oretizy03/Soil-Monitoring-System/Soil_Monitoring_for_Smart_Agriculture.pptx

SOIL
MONITORING
FOR SMART
AGRICULTURE

Sensor-based soil monitoring with real-time measurements, local classification and an offline dashboard

EEG 323 — Instrumentation and Measurement II | Group 2

Department of Electrical and Electronics Engineering · University of Lagos
Supervisor: Dr. Olumide Akintunde Alamu

ESP32

SENSE → PROCESS → DISPLAY

MOISTURE

TEMP

pH

## Slide 2

THE PROBLEM

Soil decisions are only as good as the measurements behind them

The project turns three invisible soil conditions into numbers a farmer can act on.

02

Farmers may rely on soil appearance, touch and experience when measurement tools are unavailable.

1

Traditional judgment

THE DESIGN RESPONSE

Measure locally.
Process immediately.
Explain the result.

A compact ESP32 instrument combines sensing, calibration, classification and a local user interface in one build.

Accurate testing can require money, time and access to a laboratory — unsuitable for every immediate irrigation decision.

Laboratory testing

2

Imported or specialised equipment can be difficult to maintain when a component fails.

3

Instrument access

REAL-TIME

OFFLINE

SOIL MONITORING FOR SMART AGRICULTURE

EEG 323 • Group 2 • University of Lagos

## Slide 3

AIM & OBJECTIVES

A small instrument with a clear job

Measure soil moisture, temperature and pH, then turn readings into usable information.

03

Design and implement a sensor-based system that measures soil moisture, temperature and pH, and processes and displays those readings in real time to support irrigation and crop management decisions.

The final build is intended to be portable, maintainable and usable without engineering know-how.

AIM

Portable

Stable enough to carry to and from the farm.

1

Maintainable

Built from commonly available parts and simple interfaces.

2

Operable

Useful without needing a laptop during normal operation.

3

SUCCESS LOOKS LIKE

LIVE VALUES

CALIBRATED

LOCAL UI

SOIL MONITORING FOR SMART AGRICULTURE

EEG 323 • Group 2 • University of Lagos

## Slide 4

MEASUREMENTS

Why measure moisture, temperature and pH?

These three measurements describe different parts of the soil environment — water availability, thermal conditions and chemical availability.

04

MOISTURE

41 %

Indicates how much water is available in the root zone and directly supports irrigation decisions.

< 30% DRY · 30–70% GOOD · ≥ 70% WET

TEMPERATURE

27.7 °C

Tracks the thermal condition of the soil environment, which affects germination, microbial activity and nutrient availability.

10-bit DS18B20 · 0.25 °C RESOLUTION

pH

9.29

Shows the chemical condition of the soil and helps indicate whether nutrient uptake may be limited by acidity or alkalinity.

< 6.5 ACIDIC · 6.5–7.5 NEUTRAL · > 7.5 ALKALINE

1

2

3

In this project, the readings are not presented as raw numbers only — the firmware also translates them into plain-language categories.

SOIL MONITORING FOR SMART AGRICULTURE

EEG 323 • Group 2 • University of Lagos

## Slide 5

SYSTEM ARCHITECTURE

One controller, three sensors, two user interfaces

The system is organised as a sensing layer, a processing layer and a display/network layer.

05

CAPACITIVE MOISTURE

GPIO34 · analogue

ESP32
DEVKIT V1

Acquire • Calibrate • Classify • Buffer

100 µF + 100 nF decoupling

SH1106 OLED

1.3″ local display over shared I²C

DS18B20

GPIO4 · 1-Wire

WI-FI SOFT AP

Captive-portal dashboard · multi-device

PH4502C

GPIO35 · via divider

POWER STAGE

ASM1117 → dedicated 5 V rail for pH front-end

ESP32 logic rail: 3.3 V

SOIL MONITORING FOR SMART AGRICULTURE

EEG 323 • Group 2 • University of Lagos

## Slide 6

HARDWARE BUILD

The build is modular: each part has one job

Keeping sensing, conditioning and display roles separate makes the system easier to debug and maintain.

06

SENSE

Capacitive moisture v1.2

Analogue soil-water proxy · GPIO34

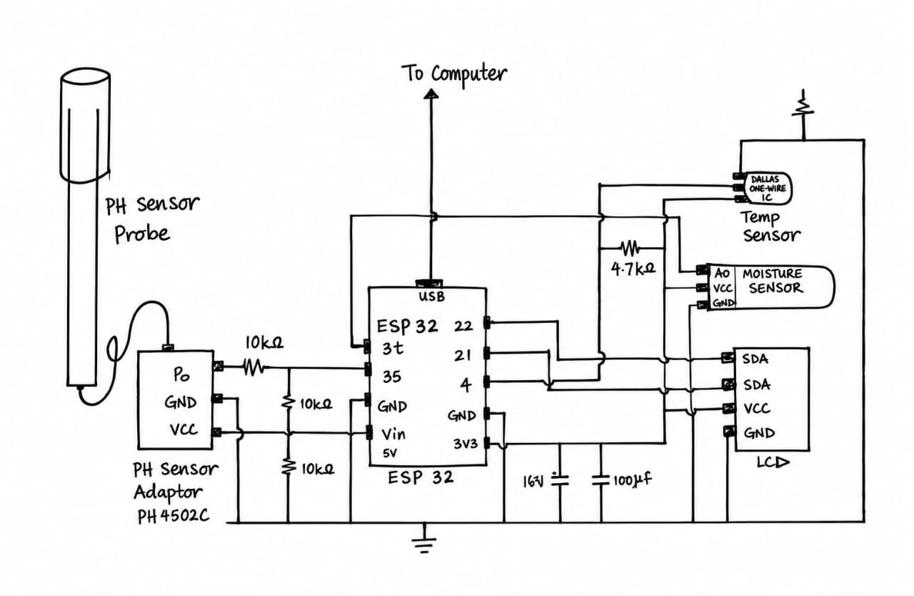
[picture p3: figure]

Reference circuit diagram from the original build

SENSE

DS18B20

Digital temperature · GPIO4 · 4.7 kΩ pull-up

CONDITION

PH4502C

Conditions the pH electrode signal · 0–5 V stage

PROTECT

10 kΩ / 20 kΩ divider

Scales pH output before GPIO35

DISPLAY

SH1106 1.3″ OLED

Shared I²C local display

POWER

LM2596 + capacitors

Dedicated 5 V rail + transient buffering

BUILD PRINCIPLE

Sensors produce signals; the controller never has to “guess” what a pin is supposed to mean.

EEG 323 • Group 2 • University of Lagos

SOIL MONITORING FOR SMART AGRICULTURE

## Slide 7

SIGNAL & POWER INTEGRITY

The final build depends on clean signal paths

Most of the engineering detail sits between the sensor output and the ESP32 ADC.

07

The divider scales the 0–5 V conditioned signal to an ESP32-safe range near 0–3.3 V while preserving the linear relationship used for calibration.

OTHER PROTECTION / STABILITY DETAILS

pH SIGNAL PATH

PH4502C

FINAL WIRING CHECK

Moisture → GPIO34 analogue

DS18B20 DATA → GPIO4

pH → divider → GPIO35

OLED uses shared I²C lines

pH front-end gets dedicated 5 V

ESP32 logic remains at 3.3 V

This separation is what stopped Wi-Fi activity from disturbing the analogue pH measurement.

10 kΩ
20 kΩ

ESP32
GPIO35

✓

✓

✓

✓

✓

4.7 kΩ

100 µF

100 nF

✓

DS18B20 1-Wire pull-up

Rail reservoir

High-frequency decoupling

SOIL MONITORING FOR SMART AGRICULTURE

EEG 323 • Group 2 • University of Lagos

## Slide 8

FIRMWARE

Firmware turns raw signals into readable soil status

The main loop runs once per second while calibration, averaging and history buffers make the output more useful than a raw ADC value.

08

ACQUIRE

Sensors → raw values

1

CALIBRATE

Raw ADC → engineering
units

2

CLASSIFY

Moisture / pH → plain
language

3

BUFFER

5 seconds + 1 hour history

4

DISPLAY

OLED + local dashboard

5

Read DS18B20 temperature

Read moisture ADC → percentage

Read pH from 20 averaged samples

Update OLED and dashboard variables

Log to the 5-second and 1-hour buffers

Moisture % = (ADCraw − ADCair) ÷ (ADCwater − ADCair) × 100

pH = 7.0 − (ADCraw − ADCpH7) × 4.5 ÷ (ADCpH2.5 − ADCpH7)

The calibration points are measured on the actual sensors used in the build.

MAIN LOOP · ~1 SECOND

CALIBRATION FORMULAS

1

2

3

4

5

SOIL MONITORING FOR SMART AGRICULTURE

EEG 323 • Group 2 • University of Lagos

## Slide 9

USER INTERFACE

The system works without a PC or router

A local OLED gives immediate feedback; the ESP32 soft AP provides a browser dashboard to phones and laptops.

09

SH1106 OLED

SMART SOIL MONITOR

TEMP 27.7°C
MOIST 41%
pH 9.29

LOCAL DISPLAY · NO APP REQUIRED

BROWSER DASHBOARD

SMART_SOIL_MONITOR

Join the ESP32 access point from Android, iOS or Windows and open the captive portal.

27.7 °C

TEMPERATURE

41 %

MOISTURE

9.29

PH

24-HOUR HISTORY

5-SECOND BUFFER

NO INTERNET

SOIL MONITORING FOR SMART AGRICULTURE

EEG 323 • Group 2 • University of Lagos

## Slide 10

DATA INTERPRETATION

The firmware explains the measurement

Calibration anchors raw ADC values to known conditions, then the classification layer makes the result understandable at a glance.

10

MOISTURE CALIBRATION

2469

41 % → GOOD

The same mapping is applied continuously to the live ADC reading.

pH CALIBRATION

9.29 → ALKALINE

Twenty samples are averaged before the pH value is updated.

PLAIN-LANGUAGE CLASSIFICATION

AIR

WATER

752

pH 7.0 ADC

2975

pH 2.5 ADC

3790

MOISTURE

< 30%

DRY

MOISTURE

30–70%

GOOD

MOISTURE

pH

≥ 70%

< 6.5

WET

ACIDIC

pH

6.5–7.5

NEUTRAL

pH

> 7.5

ALKALINE

ACTIONABLE STATUS

SOIL MONITORING FOR SMART AGRICULTURE

EEG 323 • Group 2 • University of Lagos

## Slide 11

RESULTS

Bench testing shows the complete signal chain working

The final build produced stable live values, calibrated classifications and a much faster acquisition loop.

11

27.7 °C

TEMPERATURE

Stable at 0.25 °C resolution

41 %

MOISTURE

Classified “Good” from calibrated endpoints

9.29

SOIL pH

Classified “Alkaline” from pH 7 and 2.5 points

187 ms

CONVERSION TIME

Down from ~750 ms after using 10-bit DS18B20 resolution

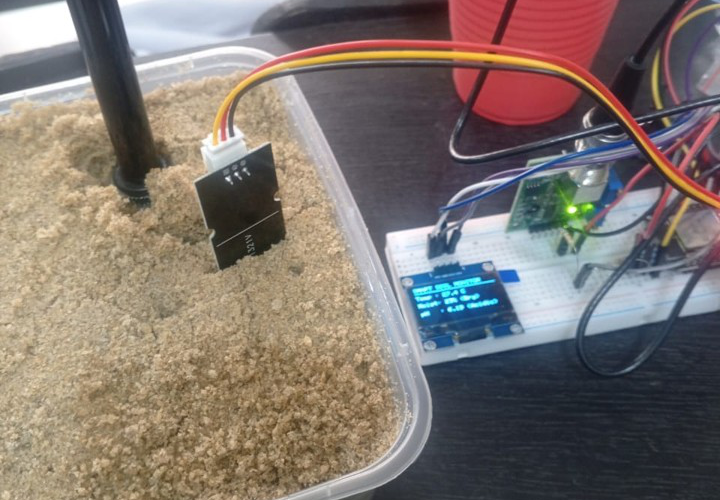
[picture p4: figure]

TEST SETUP

WHAT THE RESULT MEANS

The important result is not a single “perfect” number. It is that the complete chain — sensor → conditioning → ESP32 → classification → interface — remains coherent and
usable in operation.

Bench testing used the completed sensor assembly and compared the live values produced by the firmware against the intended calibrated behaviour.

LIVE

CALIBRATED

OFFLINE

SOIL MONITORING FOR SMART AGRICULTURE

EEG 323 • Group 2 • University of Lagos

## Slide 12

LIVE DASHBOARD

The finished system turns sensor readings into usable data

The ESP32 dashboard exposes the current state, recent samples and a longer-term trend view for practical decisions.

11

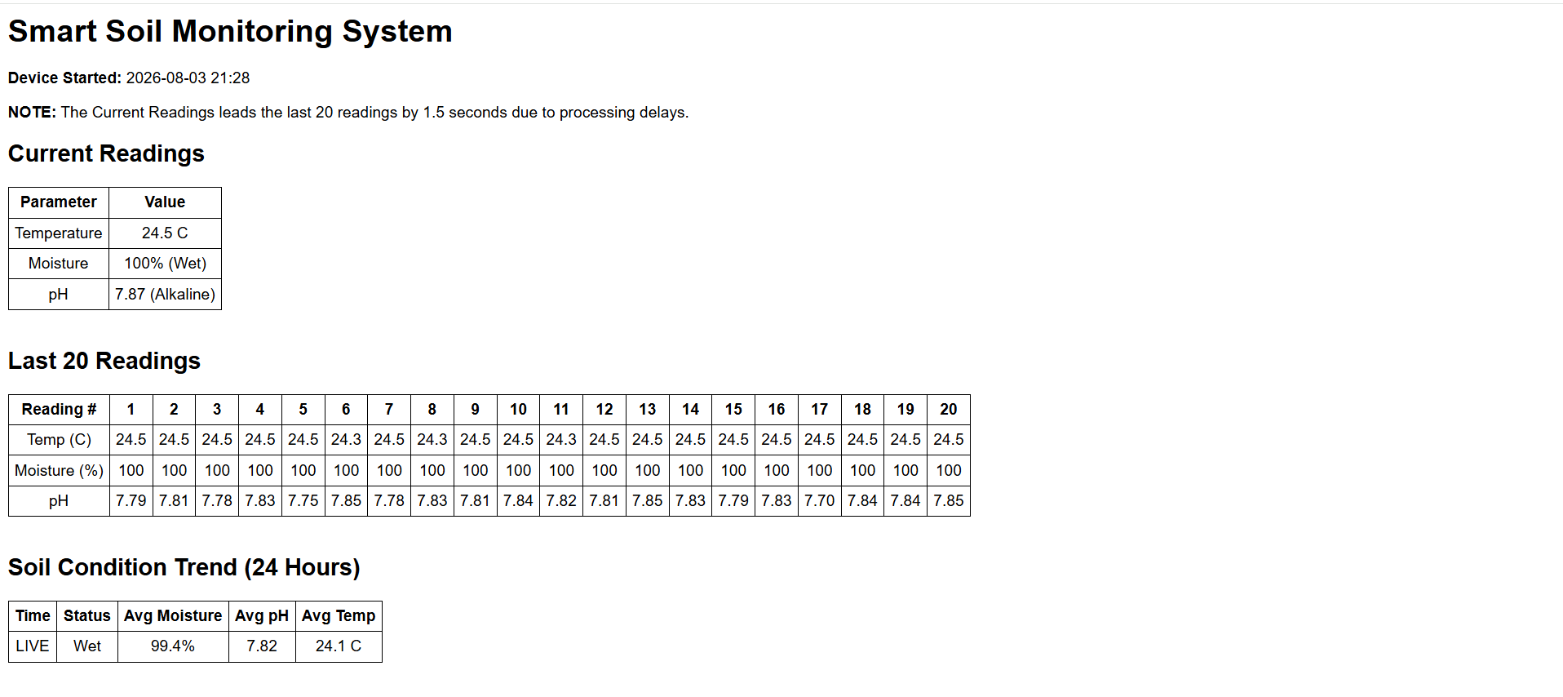
[picture p5: figure]

EXAMPLE CAPTURE • ESP32 LOCAL WEB DASHBOARD

SOIL MONITORING FOR SMART AGRICULTURE

DATA APPLICATIONS

CURRENT STATE

24.5 °C · 100% moisture (Wet) · pH 7.87 (Alkaline)

SHORT-TERM HISTORY

The last 20 readings expose stability and variation before a decision is made.

TREND + DECISION

The 24-hour buffer can reveal drying, pH movement or temperature changes over time.

EEG 323 • Group 2 • University of Lagos

1

2

3

LIVE

OFFLINE

LOCAL

## Slide 13

APPLICATIONS

Where the finished system can be used

The current build is especially suited to situations where local measurements and immediate interpretation are more useful than a remote infrastructure stack.

13

Irrigation decisions

Use live moisture status to support when-to-water decisions rather than relying only on visual judgement.

1

Crop management

Track temperature and pH alongside moisture to build a more complete picture of the root-zone environment.

2

Offline field monitoring

Operate from the ESP32’s local display and Wi-Fi soft AP without a router, internet connection or phone app.

3

Prototype platform

Extend the same architecture with automatic irrigation, more sensor nodes, longer-term logging or additional soil measurements.

4

NEXT EXTENSIONS

AUTO IRRIGATION

SOLAR + BATTERY

ESP-NOW / LORA

SD / CLOUD LOGGING

NPK SENSING

MOBILE ALERTS

SOIL MONITORING FOR SMART AGRICULTURE

EEG 323 • Group 2 • University of Lagos

## Slide 14

GITHUB COMPANION

A project page should show more than the firmware

The code explains how the controller behaves; this deck explains why the hardware, calibration and user interface were built that way.

14

HARDWARE

What each sensor does
Why the signal is compatible
Where protection is required

FIRMWARE

Acquisition order
Calibration equations
Classification + buffering

VALIDATION

Measured values
Conversion-time improvement
Faults that were fixed

APPLICATION

How a farmer would use it
What “offline” means
How the platform can grow

Build overview, Wiring , Firmware, Calibration , Test Results , Applications.

REPOSITORY CONTENTS:

SOIL MONITORING FOR SMART AGRICULTURE

EEG 323 • Group 2 • University of Lagos

## Slide 15

CONCLUSION

The system met its core objectives

15

CORE BUILD

ESP32
+
3 sensor inputs
+
local display
+
local dashboard

1

Real-time moisture, temperature and pH monitoring in a low-cost embedded build.

2

Calibrated conversion from raw sensor outputs into interpretable soil status.

Safe pH voltage matching, dedicated 5 V power and decoupling for stable analogue behaviour.

3

4

Local OLED + Wi-Fi dashboard with 24-hour history and no router, internet connection or app.

A compact instrumentation project with a complete sensing → processing → interface pipeline.

From raw voltage to an actionable soil reading.

## Slide 16

Thank you

Soil Monitoring for Smart Agriculture

A practical embedded instrumentation project built to make soil conditions measurable, visible and usable.

Group 2 · EEG 323 Instrumentation and Measurement II
Department of Electrical and Electronics Engineering · University of Lagos
