oretizy03/Soil-Monitoring-System/(commit log)

2026-10-03 Refactor SMART_SOIL_MONITOR.ino: streamline comments and fix OLED text display issue
    [SMART_SOIL_MONITOR.ino]
2026-10-03 Add SENSOR_CALIBRATION.ino: implement standalone calibration utility for moisture sensor and pH probe
2026-10-03 Add SENSOR_CALIBRATION utility and SMART_SOIL_MONITOR implementation; update main.cpp includes
2026-10-03 Add SENSOR_CALIBRATION utility: implement standalone calibration for moisture sensor and pH probe
2026-10-03 Create README.md for Soil Monitoring project
    Added a comprehensive README for the Soil Monitoring project, detailing the project's overview, objectives, technical background, system design, firmware, calibration, and future improvements.
2026-10-04 Replace LM2940CT-5.0 with AMS1117 5V regulator
    Updated the component list to replace the 5V Linear Voltage Regulator with AMS1117 5V regulator.
2026-10-16 Add ESP32 sensor system block diagram image
2026-10-17 Replace LM2940CT-5.0 with AMS1117 voltage regulator for improved power stability
2026-10-22 Add DIY Soil Moisture Sensor Prototype image and update README formatting
